eChook/Current-Sensor-Breakout/(commit log)

2022-01-04 Finalized panel - ordered
    [LEM_Breakout_Board-NPTH.drl, LEM_Breakout_Board-PTH.drl, LEM_Breakout_Board.gbl, LEM_Breakout_Board.gbo, LEM_Breakout_Board.gbp, LEM_Breakout_Board.gbr, LEM_Breakout_Board.gbrjob, LEM_Breakout_Board.gbs]
2023-06-26 Updated layout for Grove Connector
    [LEM_Breakout_Board.kicad_pcb, LEM_Breakout_Board.kicad_sch]
2023-06-26 Improved Cap placement and routing
    [LEM_Breakout_Board.kicad_pcb]
